SeBassTian23/ESP32-WeatherStation/include/parameters.h

/*
 * Parameter Labels
 */

const char* TEMPERATURE         = "Temperature [C]";
const char* REL_HUMIDITY        = "rel. Humidity [%]";
const char* PRESSURE            = "Pressure [hPa]";
const char* PRESSURE_PMSL       = "Pressure (PMSL) [hPa]";
const char* AIR                 = "Air [KOhms]";

const char* LIGHT_VISIBLE       = "Light (visible)";
const char* LIGHT_IR            = "Light (IR)";
const char* LIGHT_UV            = "Light (UV)";
const char* UV_INDEX            = "UV-Index";

const char* PM_ENV_1            = "PM1.0 [ug/m3]";
const char* PM_ENV_25           = "PM2.5 [ug/m3]";
const char* PM_ENV_100          = "PM10.0 [ug/m3]";

const char* PARTICLE_SIZE_3     = ">0.3 [um/0.1L]";
const char* PARTICLE_SIZE_5     = ">0.5 [um/0.1L]";
const char* PARTICLE_SIZE_10    = ">1.0 [um/0.1L]";
const char* PARTICLE_SIZE_25    = ">2.5 [um/0.1L]";
const char* PARTICLE_SIZE_50    = ">5.0 [um/0.1L]";
const char* PARTICLE_SIZE_100   = ">10.0 [um/0.1L]";

const char* HEAT_INDEX          = "Heat Index [C]";
const char* DEW_POINT           = "Dew Point [C]";
const char* AQI                 = "AQI";

const char* BATTERY             = "Battery [V]";
