SeBassTian23/ESP32-WeatherStation/(commit log)

2020-12-28 Update: Battery issues (cold weather)
2023-09-27 Update to PMS7003 and new ESP32 Board
